MichalAntkowiak/pilot/pilot.kicad_pcb

## KiCad design pilot.kicad_pcb (2026-10-01)

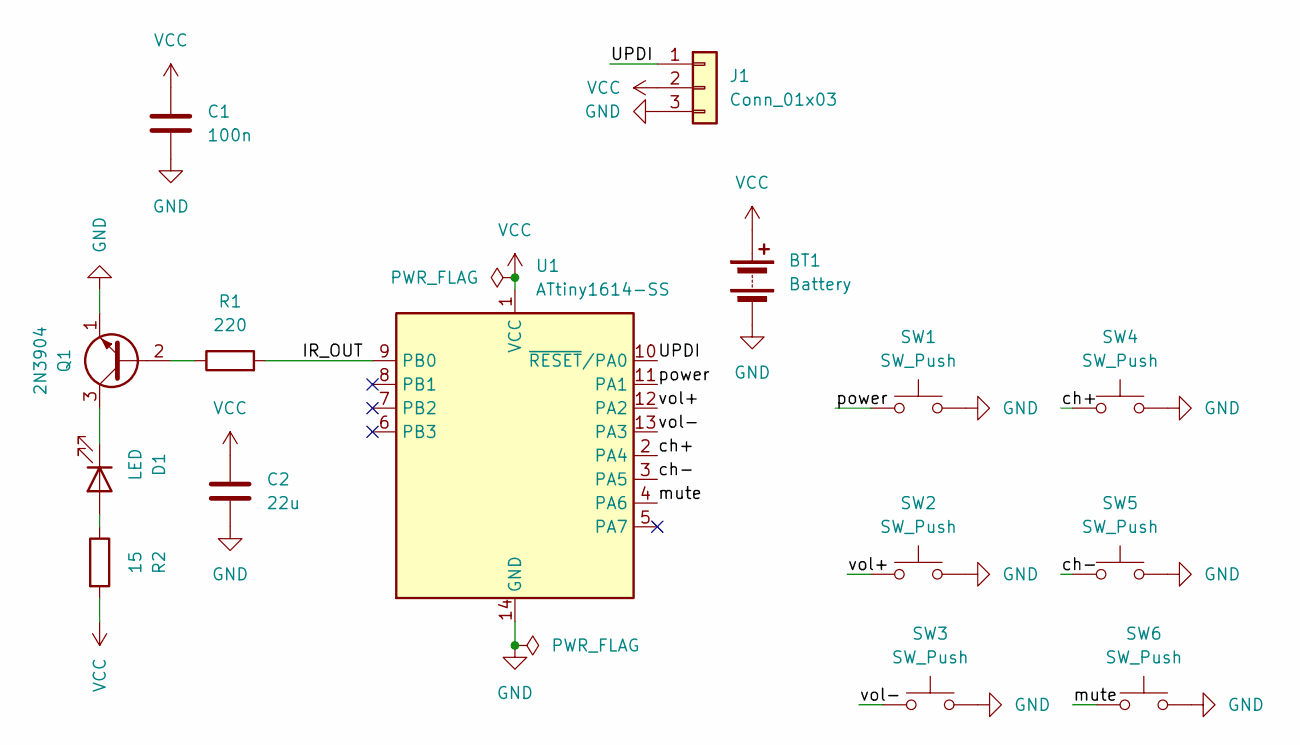
[picture p4: schematic pilot.kicad_sch]

Parts:
BT1: Battery; BatteryHolder_Keystone_2468_2xAAA
C1: 100n; C_0805_2012Metric
C2: 22u; C_1206_3216Metric
D1: LED; LED_D5.0mm_Horizontal_O1.27mm_Z3.0mm
J1: Conn_01x03; PinHeader_1x03_P2.54mm_Vertical
Q1: 2N3904; TO-92_Inline
R1: 220; R_0805_2012Metric
R2: 15; R_0805_2012Metric
SW1, SW2, SW3, SW4, SW5, SW6: SW_Push; SW_PUSH_6mm
U1: ATtiny1614-SS; SOIC-14_3.9x8.7mm_P1.27mm

Connections:
/IR_OUT: R1.2, U1.9 (PB0)
/UPDI: J1.1, U1.10 (~RESET/PA0)
/ch+: SW4.1, U1.2 (PA4)
/ch-: SW5.1, U1.3 (PA5)
/mute: SW6.1, U1.4 (PA6)
/power: SW1.1, U1.11 (PA1)
/vol+: SW2.1, U1.12 (PA2)
/vol-: SW3.1, U1.13 (PA3)
GND: BT1.2 (-), C1.2, C2.2, J1.3, Q1.1 (E), SW1.2, SW2.2, SW3.2, SW4.2, SW5.2, SW6.2, U1.14 (GND)
unnamed: D1.2 (A), R2.1
unnamed: D1.1 (K), Q1.3 (C)
unnamed: Q1.2 (B), R1.1
VCC: BT1.1 (+), C1.1, C2.1, J1.2, R2.2, U1.1 (VCC)

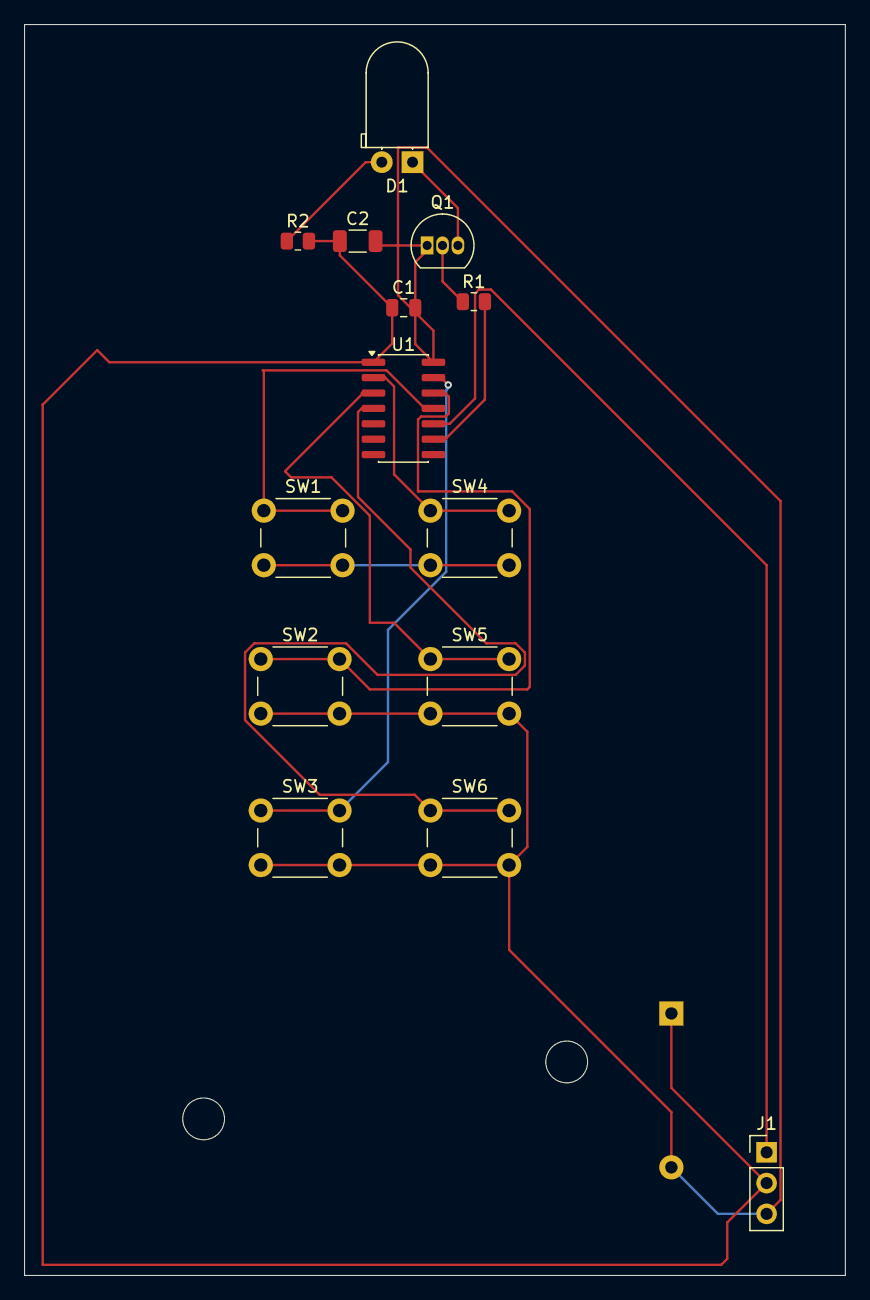
[picture p5: board pilot.kicad_pcb from above]

Board: 2 copper layers, 67.8 x 103.2 mm, 15 parts (1 on the bottom side), 13 nets.
